selmanithe1/PCB_Catre_2W/Untitled6 (2).png

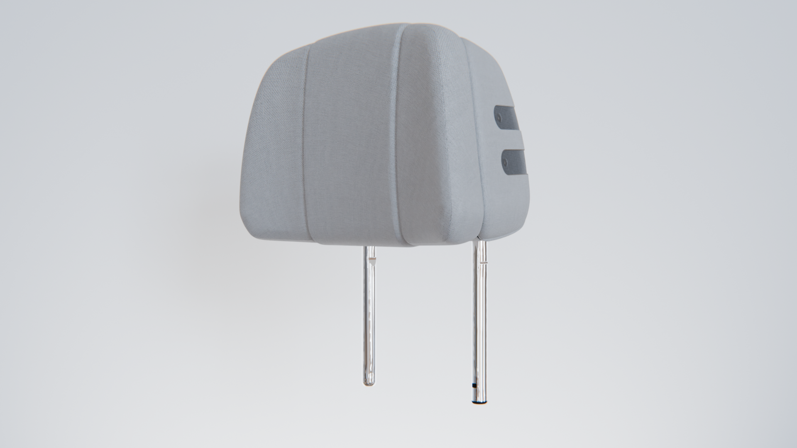
Untitled6 (2).png
