selmanithe1/PCB_Catre_2W/Untitled4 (2).png

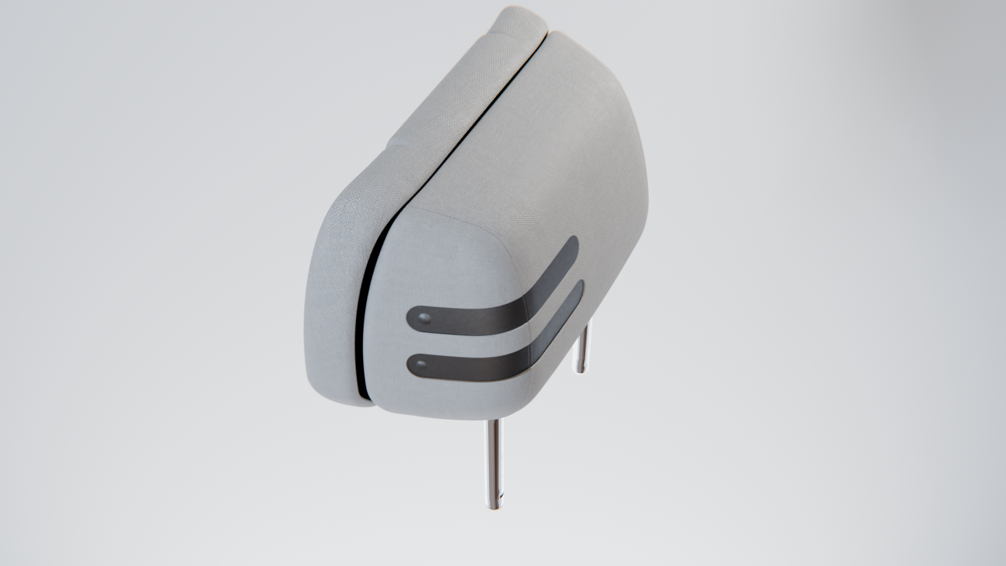
Untitled4 (2).png
