selmanithe1/PCB_Catre_2W/image006.png

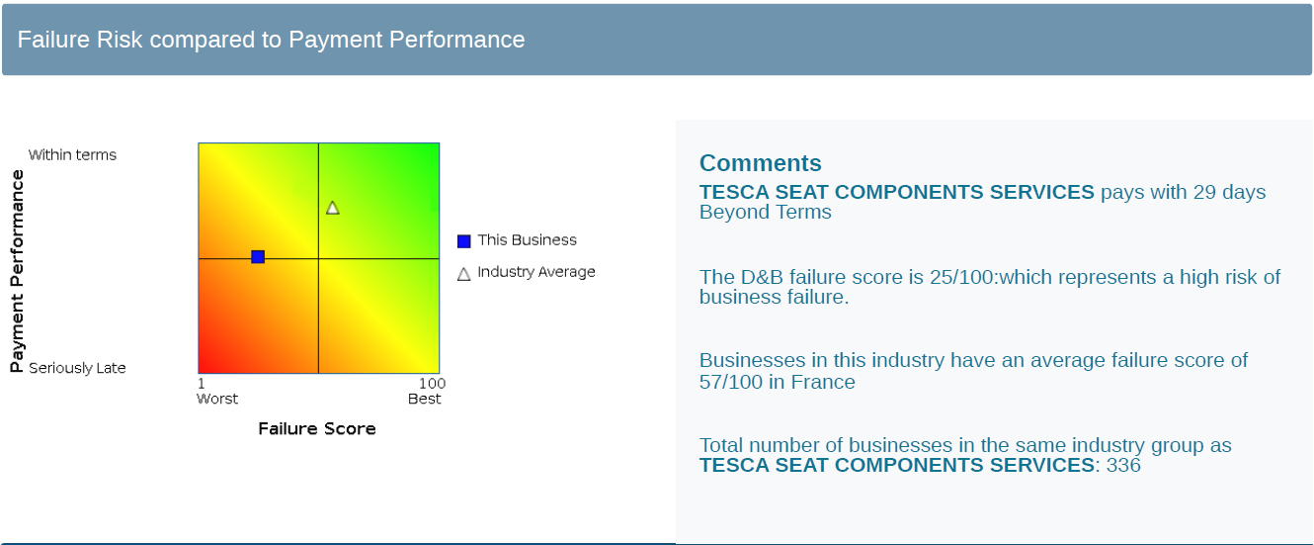
image006.png
