selmanithe1/PCB_Catre_2W/image009.png

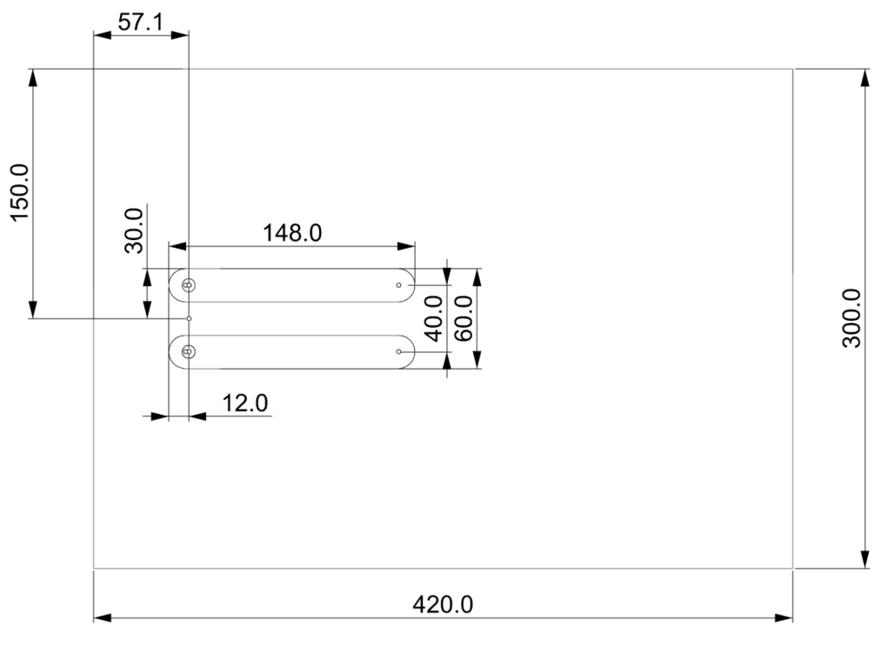
image009.png
