selmanithe1/PCB_Catre_2W/image (1).png

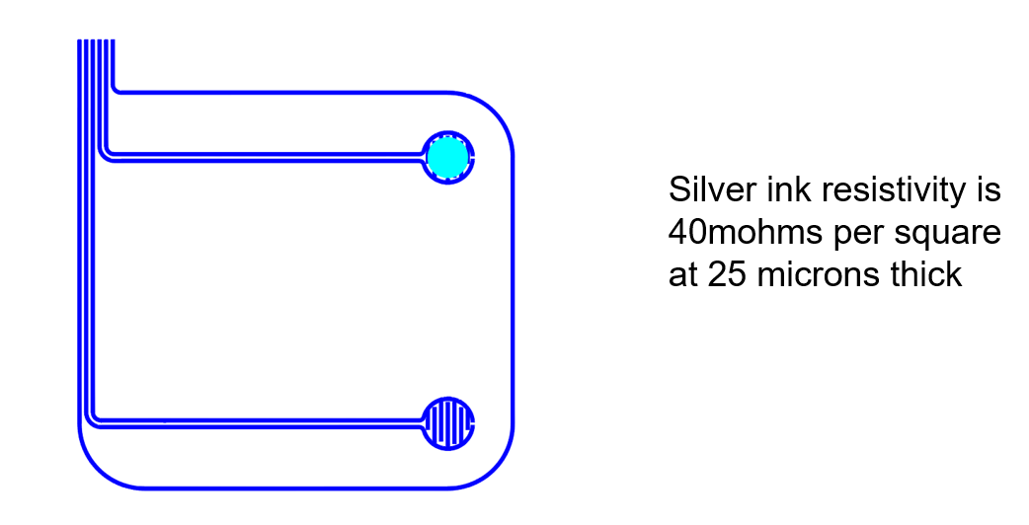
image (1).png
