selmanithe1/PCB_Catre_2W/image (2).png

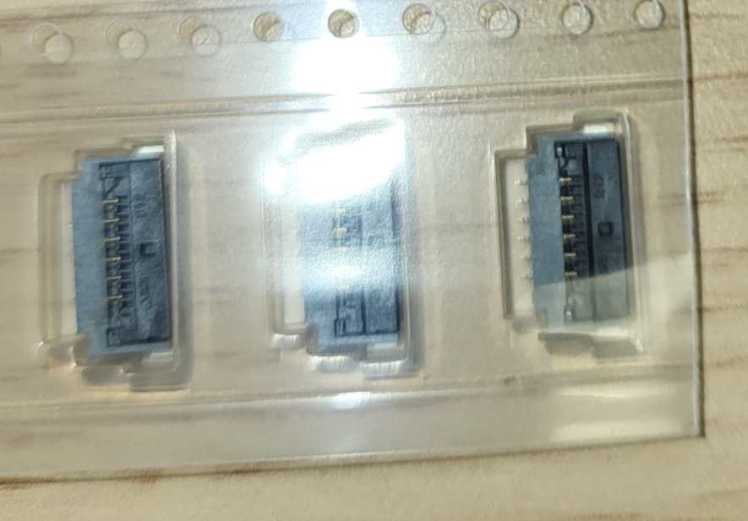
image (2).png
