selmanithe1/PCB_Catre_2W/image.png

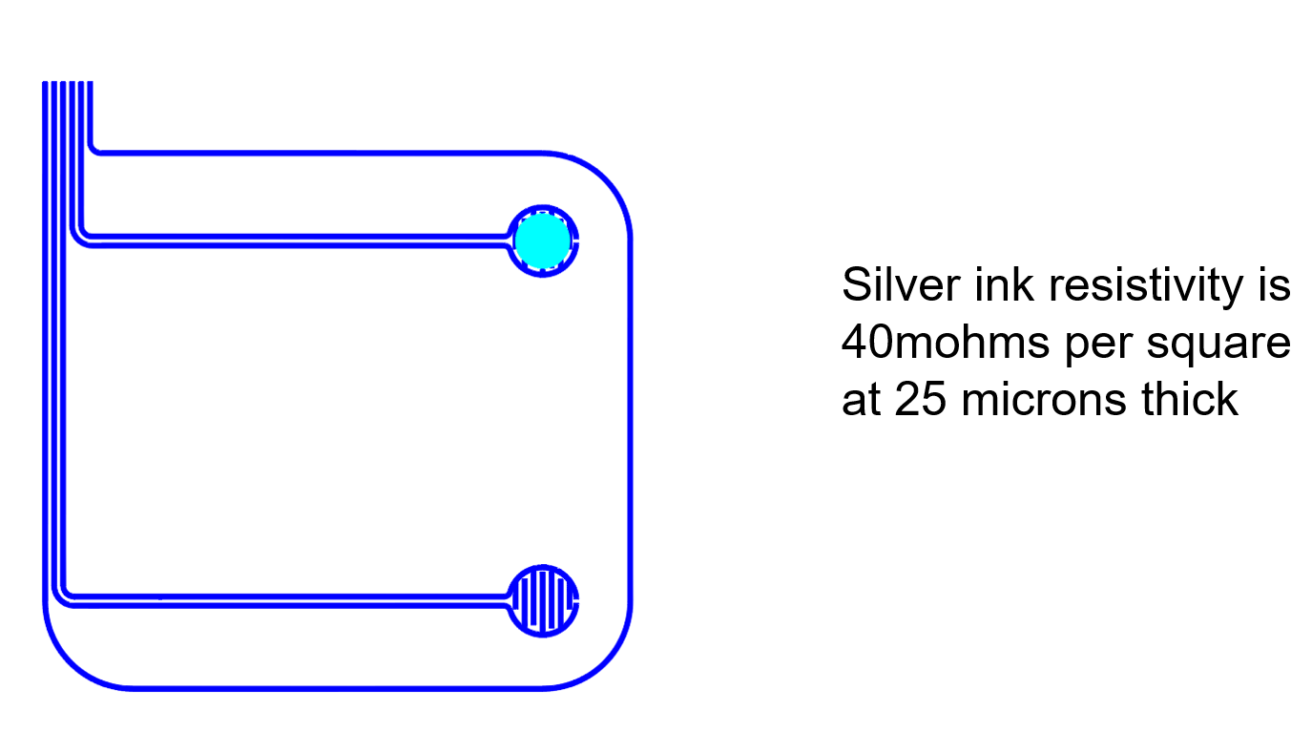
image.png
