selmanithe1/PCB_Catre_2W/Untitled3 (2).png

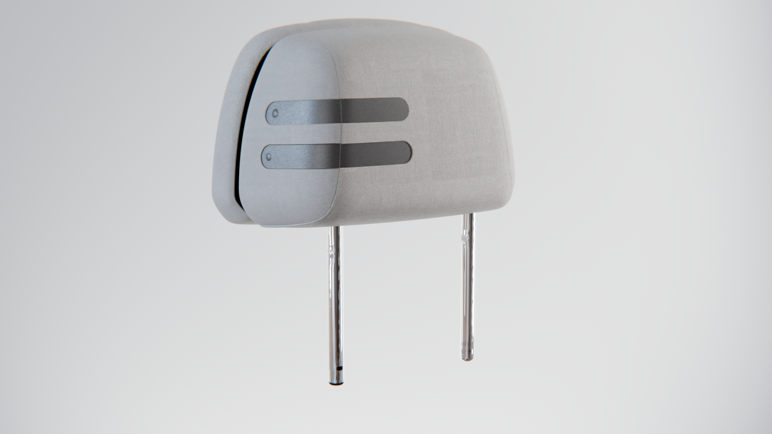
Untitled3 (2).png
