selmanithe1/PCB_Catre_2W/BOM_CardV2 copy_2025-09-15.csv

ID | Name | Designator | Footprint | Quantity | Manufacturer Part | Manufacturer | Supplier | Supplier Part | Price
1 | 10uF | C1,C2 | CAP-SMD_BD5.0-L5.3-W5.3-FD | 2 | RVT10UF25V67RV0020 | KNSCHA(科尼盛) | LCSC | C2992591 | 0.032
2 | 1000uF | C4 | CAP-SMD_BD10.0-L10.3-W10.3-FD | 1 | EEEFT1E102UP | PANASONIC(松下) | LCSC | C401766 | 0.664
3 | MM1Z5V1_C112534 | D1 | SOD-123_L2.8-W1.8-LS3.7-RD | 1 | MM1Z5V1 | 晶导微电子 | LCSC | C112534 | 0.013
4 | SS34_C908680 | D2,D3,D4,D5 | SMA_L4.3-W2.7-LS5.1-RD | 4 | SS34 | GOODWORK(固得沃克) | LCSC | C908680 | 0.029
5 | Motor | H2 | HDR-M-2.54_1X4 | 1 |  |  | LCSC | C124378 | 0.046
6 | Power | H3 | HDR-M-2.54_1X2 | 1 |  |  | LCSC | C124375 | 0.025
7 | Buttons | H4 | HDR-M-2.54_1X6 | 1 |  |  | LCSC | C190819 | 0.032
8 | L298P | L298P | POWERSO20_L15.9-W11.0-P1.27-LS14.2-BL-EP | 1 | L298P | ST(意法半导体) | LCSC | C85595 | 6.361
9 | 10kΩ | R1 | R1206 | 1 | ARG06FTC1002 | Viking(光颉) | LCSC | C294118 | 0.011
10 | 4.7kΩ | R2 | R1206 | 1 | RC1206FR-074K7L | YAGEO(国巨) | LCSC | C137262 | 0.004
11 | 180Ω | R3 | R2512 | 1 | CRH2512F180RE04Z | EVER OHMS(天二科技) | LCSC | C175292 | 0.058
12 | 1kΩ | R4 | R2010 | 1 | RS-10K1001FT | FH(风华) | LCSC | C880311 | 0.015
13 | ICS-28P | SK1 | DIP-28_L16.8-W10.1-P2.54-LS7.62-BL | 1 | Z-ICS0S28P-NG00 | Ckmtw(灿科盟) | LCSC | C146582 | 0.094
14 | LM741CN | U1 | DIP-8_L9.8-W6.6-P2.54-LS7.6-BL | 1 | LM741CN/NOPB | TI(德州仪器) | LCSC | C13974 | 0.878
15 | L7805CDT-TR | U2,U3 | TO-252-3_L6.5-W5.8-P4.58-BL | 2 | L7805CDT-TR | ST(意法半导体) | LCSC | C310413 | 0.308
16 | FM24CL16B-GTR | U5 | SOIC-8_L4.9-W3.9-P1.27-LS6.0-BL | 1 | FM24CL16B-GTR | CYPRESS(赛普拉斯) | LCSC | C31082 | 1.168
17 | SS14HE3_B/I | U7,U8 | SMA_L4.3-W2.7-LS5.1-RD | 2 | SS14HE3_B/I | VISHAY(威世) | LCSC | C467991 | 0.098
18 | 220uF | U9,U10 | CAP-SMD_BD6.3-L6.6-W6.6-LS7.2-FD | 2 | RST220UF25V019 | KNSCHA(科尼盛) | LCSC | C4747974 | 0.036
