selmanithe1/PCB_Catre_2W/3 Buttons card with capacitive sensors/Schematic_Carte_des_boutons_capacitives_2025-09-15.pdf

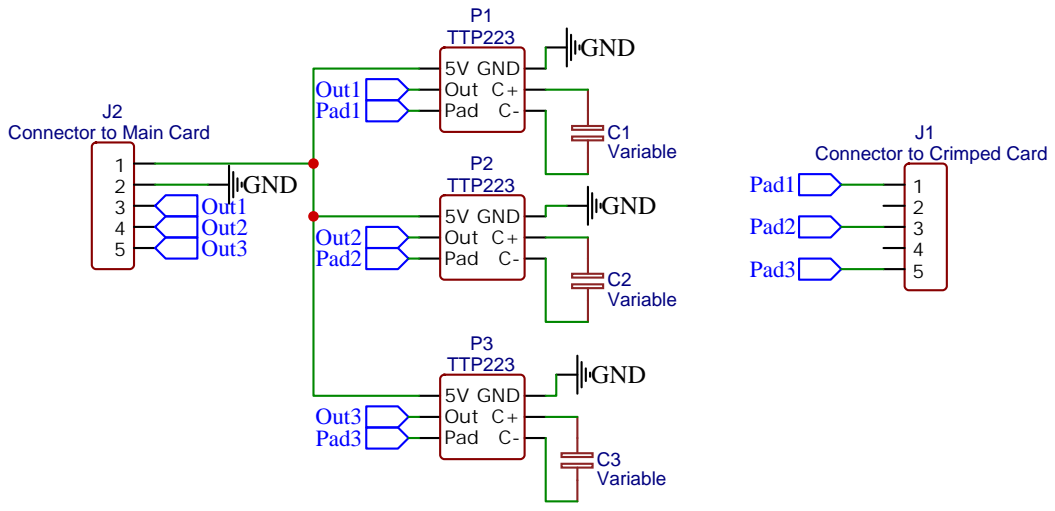
[picture p9: page 1]

Connector to Main Card
