selmanithe1/PCB_Catre_2W/3 Buttons card without capacitive sensors/Schematic_Card_Capacitive_without_capacitor_2025-09-15.pdf

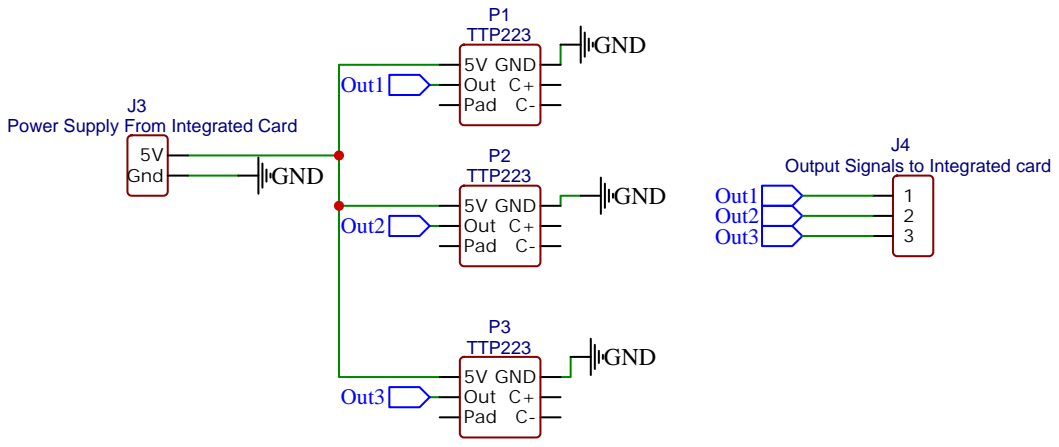
[picture p10: page 1]

Power Supply From Integrated Card
