selmanithe1/PCB_Catre_2W/Schematic_CardV2 copy_2025-09-15.pdf

14 14 15 15 16 16 17 17 18 18 19 19 20 20 21 21 22 22 23 23 24 24 25 25 26 26 27 27 28 28

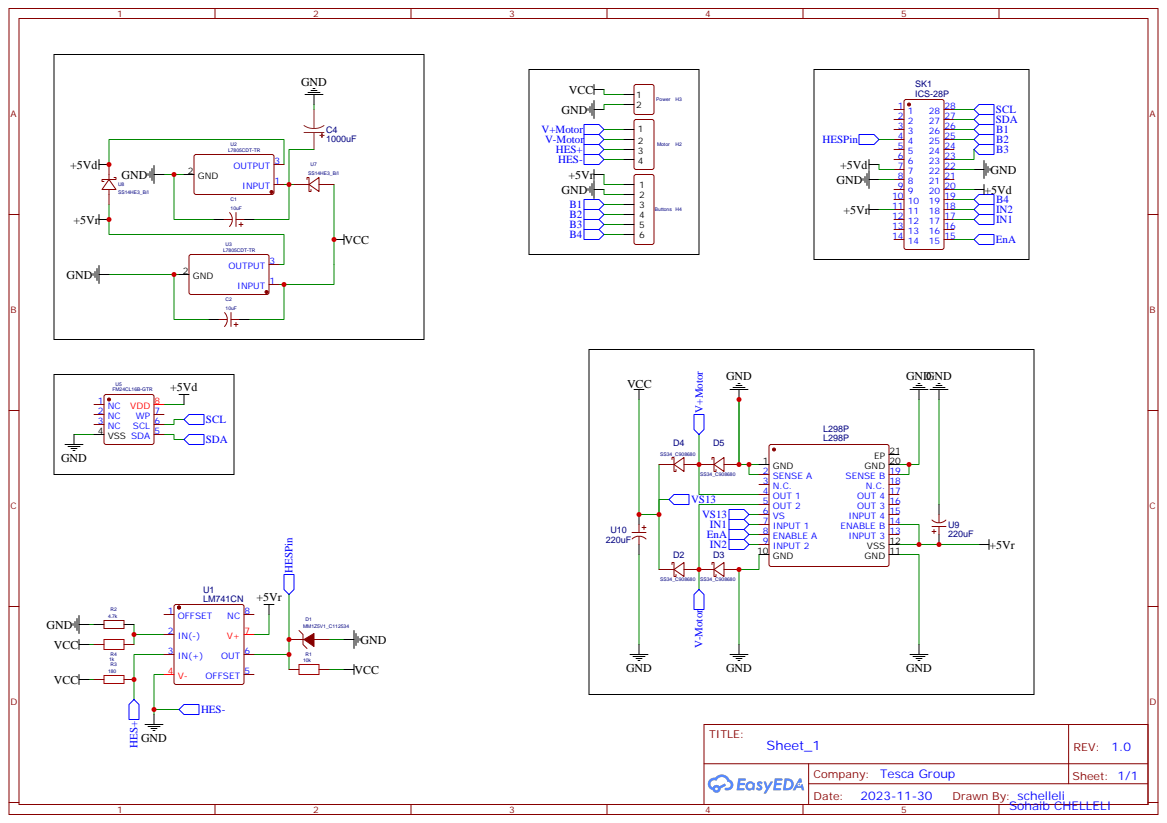
[picture p11: page 1]
