selmanithe1/PCB_Catre_2W/PCB_PCB_CardV2_2_2025-09-15.pdf

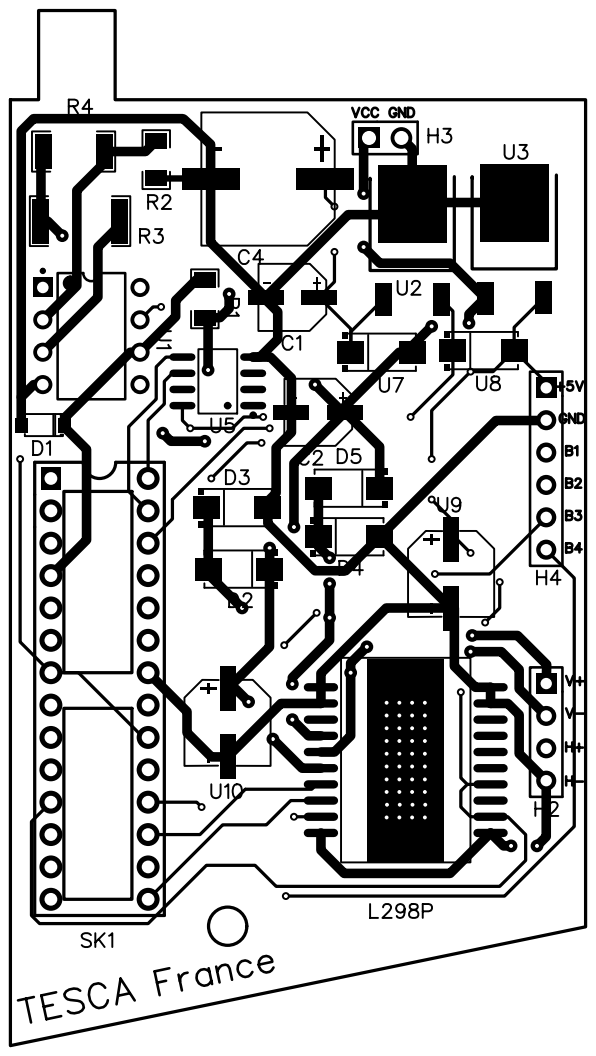
[picture p12: page 1]
