selmanithe1/PCB_Catre_2W/(list of files, drawings)

Other design files:
3 Buttons card with capacitive sensors/SCH_Carte_des_boutons_capacitives_2025-09-15.json
3 Buttons card without capacitive sensors/SCH_Card_Capacitive_without_capacitor_2025-09-15.json
PCB_PCB_CardV2_2_2025-09-15.json
SCH_CardV2 copy_2025-09-15_BACKUP.json
