selmanithe1/PCB_Catre_2W/(commit log)

2026-02-26 Add README for PCB Carte 2W project
    Added detailed project documentation for PCB Carte 2W including specifications, architecture, components, and tasks.
2026-02-27 Add technical documentation for PCB Carte 2W
    This document outlines the technical specifications and design of the PCB for a linear actuator control system, including details on components, architecture, and firmware.
2026-03-04 Add Flex PCB migration doc - LaTeX source (HES -> FPC 6-pin FH52K)
    This document outlines the migration of the sensor from Hall Effect to Flex PCB, detailing the new sensor's specifications, connector information, and necessary modifications to the PCB and firmware.
2026-03-04 Implement EasyEDA to KiCad schematic converter
    Add EasyEDA to KiCad schematic conversion script.
2026-03-04 Create easyeda_to_kicad_pcb.py for PCB conversion
    Add script to convert EasyEDA PCB JSON to KiCad PCB format.
2026-03-04 Create generate_kicad_fpc_component.py script
    Add script to generate KiCad FPC component for FH52K-12(6)SA-1SH(99)
2026-03-04 Add README_scripts.md - Guide utilisation scripts KiCad migration
